SidneyMcAdams/CRT-420-Project/README.md

# CRT 420 Project
# This is the Github Repository CRT 420 Advanced Prototyping Class
