SidneyMcAdams/CRT-420-Project/Documentation/07-Function Production.pdf

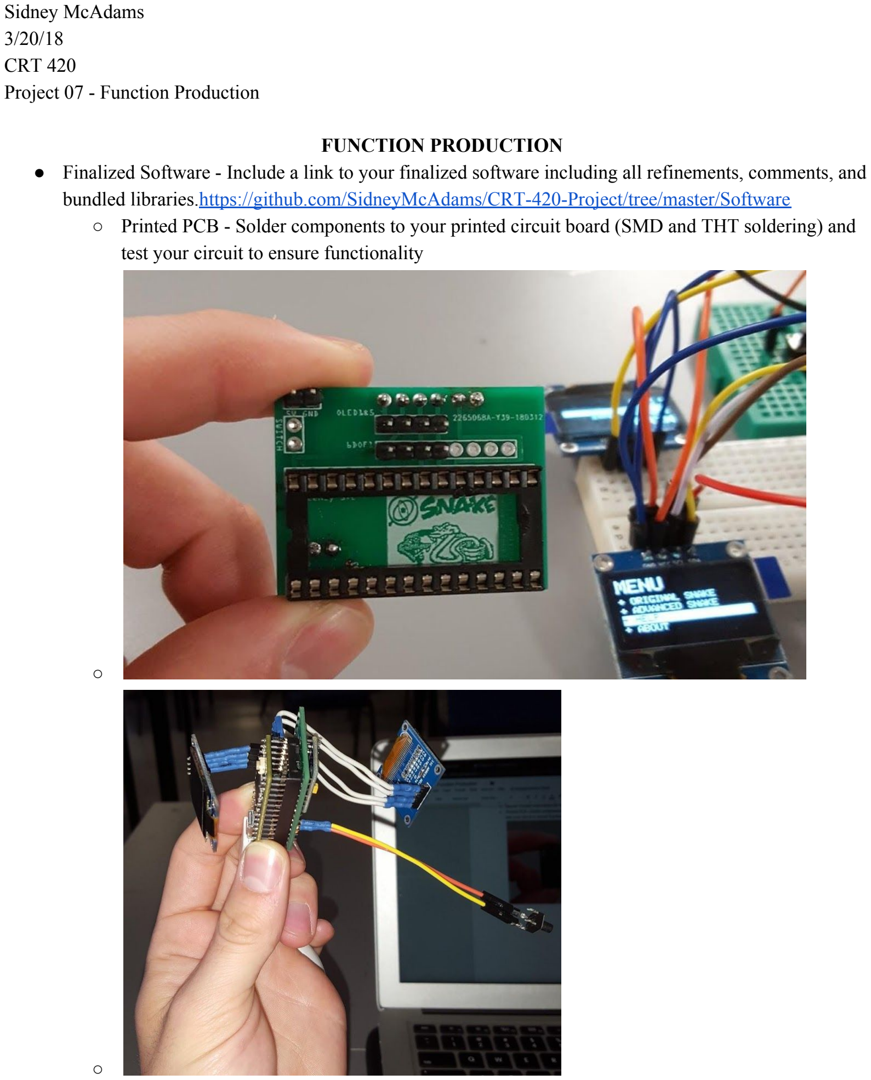
[picture p9: page 1]

Sidney McAdams
3/20/18
CRT 420
Project 07 - Function Production

FUNCTION PRODUCTION
- Finalized Software - Include a link to your finalized software including all refinements, comments, and bundled libraries.https://github.com/SidneyMcAdams/CRT-420-Project/tree/master/Software
- Printed PCB - Solder components to your printed circuit board (SMD and THT soldering) and test your circuit to ensure functionality

○

○

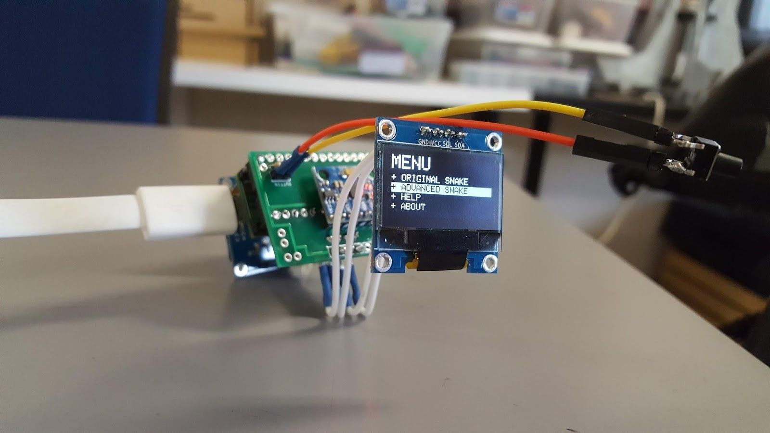
[picture p10: figure]

○
