SidneyMcAdams/CRT-420-Project/Documentation/09-Finalization.pdf

Sidney McAdams
4/11/18
CRT 420
Project 09 - Finalization

FINALIZATION

- Complete Project - Combine the functional and form components together into a completed prototype.

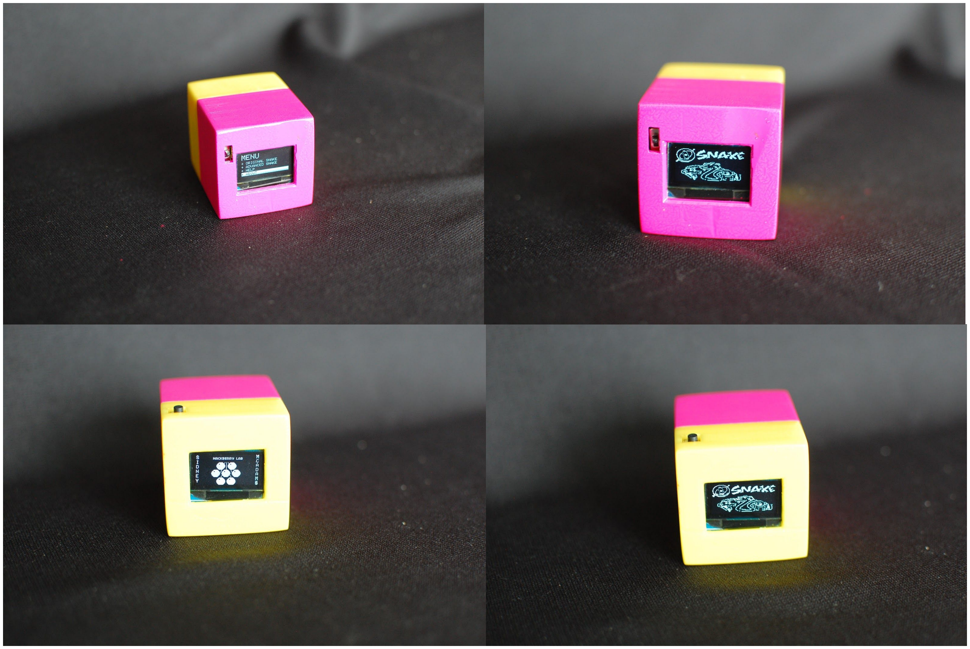
[picture p11: figure]

- User Testing - Generate a practical test of your device that includes a test of its hardware, software, and aesthetic features
■ Test with 3 individuals and record your results
- Rory: I like it.
- Meriah: Needs to be bigger.
- Dexter: Needs to be bigger.
- Power Requirements and Performance - Subject your device to power testing.
■ Test under the following conditions: idle performance, moderate usage, and frequent usage for 30 minutes each
- The device is able to be idle for up to 30+ minutes.
- It handles well to moderate and frequent usage.
- User was able to play ADVANCED SNAKE for 30+ minutes.
