SidneyMcAdams/CRT-420-Project/Documentation/08-Form Production.pdf

Sidney McAdams
3/28/18
CRT 420
Project 08 - Function Production

FORM PRODUCTION

- 3D Printed Model - Fabricate a 3D printed model based on your Fusion 360 model
■ Include any additional hardware such as standoffs, screws, etc. necessary to complete the design

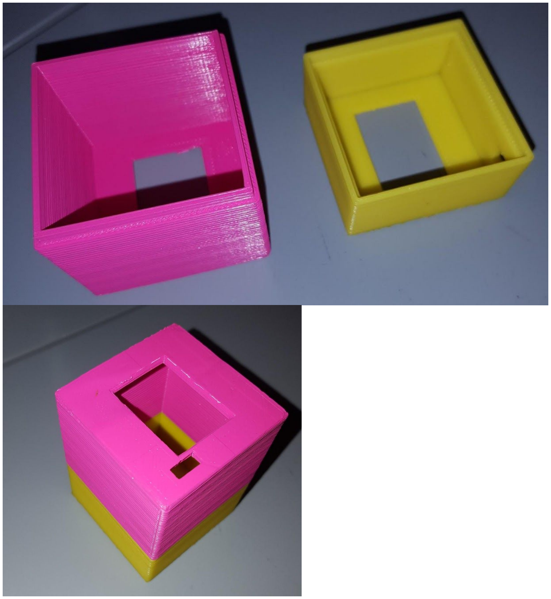
[picture p13: figure]

Before sanding and acetone vapor deposition

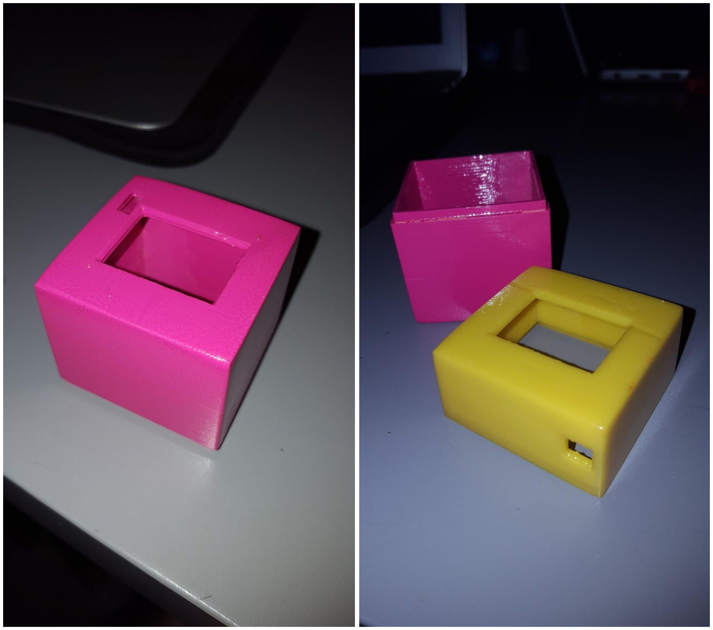
[picture p14: figure]

After sanding and acetone vapor deposition
