SidneyMcAdams/CRT-420-Project/Documentation/04-Function Development.pdf

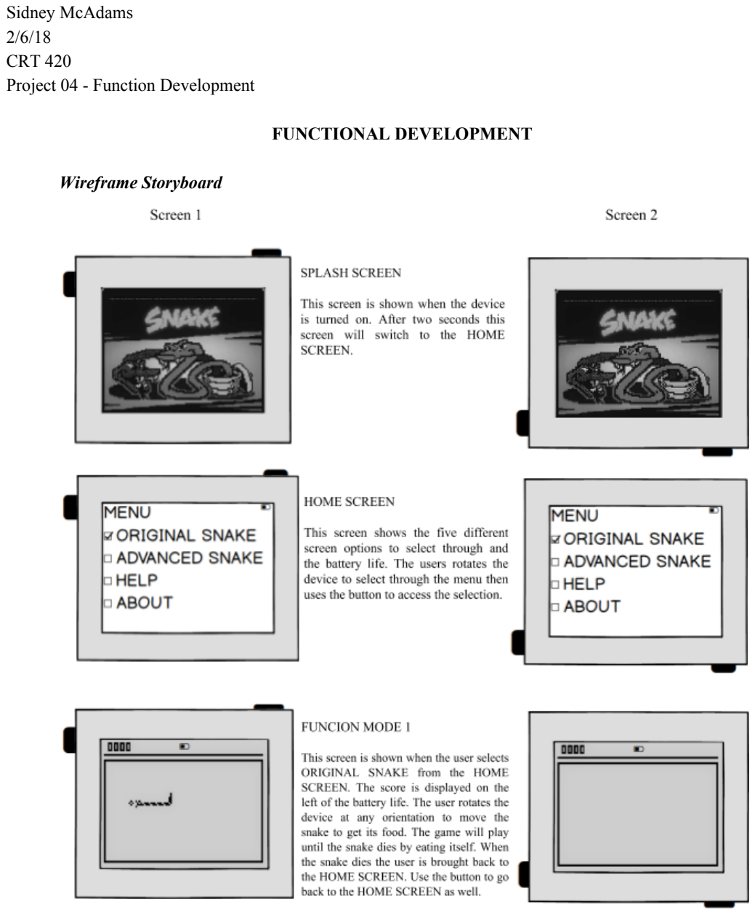
[picture p22: page 1]

Sidney McAdams
2/6/18
CRT 420
Project 04 - Function Development

FUNCTIONAL DEVELOPMENT

Wireframe Storyboard

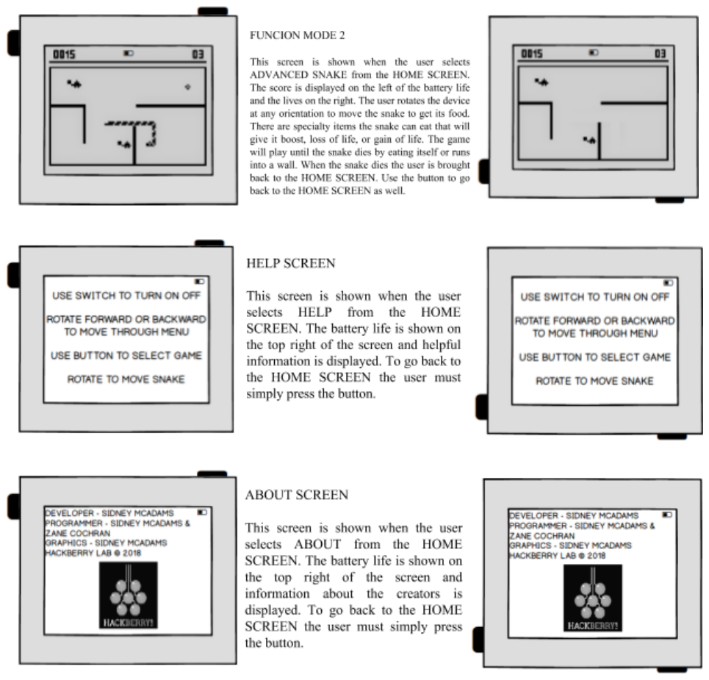
[picture p23: page 2]

Component Sketch

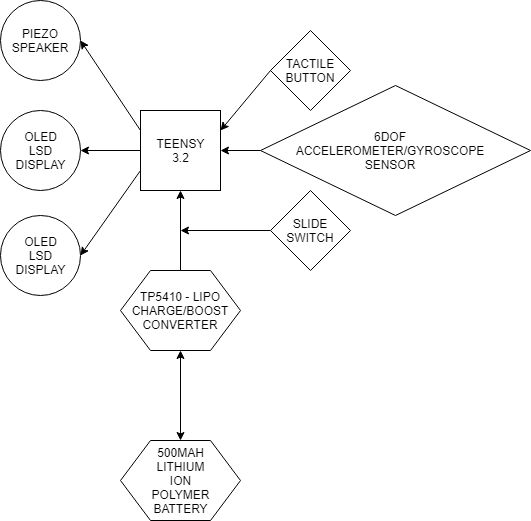
[picture p24: figure]

Bill of Materials

Item Name | Item Cost | Quantity Required | Reference URL | Purchase URL
Teensy 3.2 | $15.95 | 1 | Adafruit | https://www.adafrui t.com (https://www.adafruit.com/product/199)
.96” OLED Screen | $8.99 | 2 | Amazon | https://www.amazo n.com (https://www.amazon.com/Display-LANMU-Serial-128X64-Arduino/dp/B01G6RE2DQ)
Piezo Speaker | $.95 | 1 | Adafruit | https://www.adafrui t.com (https://www.adafruit.com/product/1740)
Slide Switch | $.95 | 1 | Adafruit | https://www.adafrui t.com (https://www.adafruit.com/product/805)
6 DOF Accelerometer/Gyr oscope Sensor | $5.09 | 1 | Amazon | https://www.amazo n.com (https://www.amazon.com/HiLetgo-MPU-6050-Accelerometer-Gyroscope-Converter/dp/B01DK83ZYQ)

Tactile Button | $2.50 | 1 | Adafruit | https://www.adafruit.com/product/367 (https://www.adafruit.com/product/367)
500mAh Lithium Ion Polymer Battery | $7.95 | 1 | Adafruit | https://www.adafrui t.com (https://www.adafruit.com/product/1578)
TP5410 - LiPo Charge/Boost Converter | $2.19 | 1 | Ebay | https://www.ebay.c om (https://www.ebay.com/itm/191990401129)
10k Ohm Resistor | $5.76 | 1 | Amazon | https://www.amazo n.com (https://www.amazon.com/Projects-10EP51210K0-10k-Resistors-Pack/dp/B0185FKB0K?s=industrial)
TOTAL: | $50.33
Breadboard Model - Create a breadboard model in Fritzing | simulating your circuit. Components should
be well spaced and wire jumpers should be discernible.

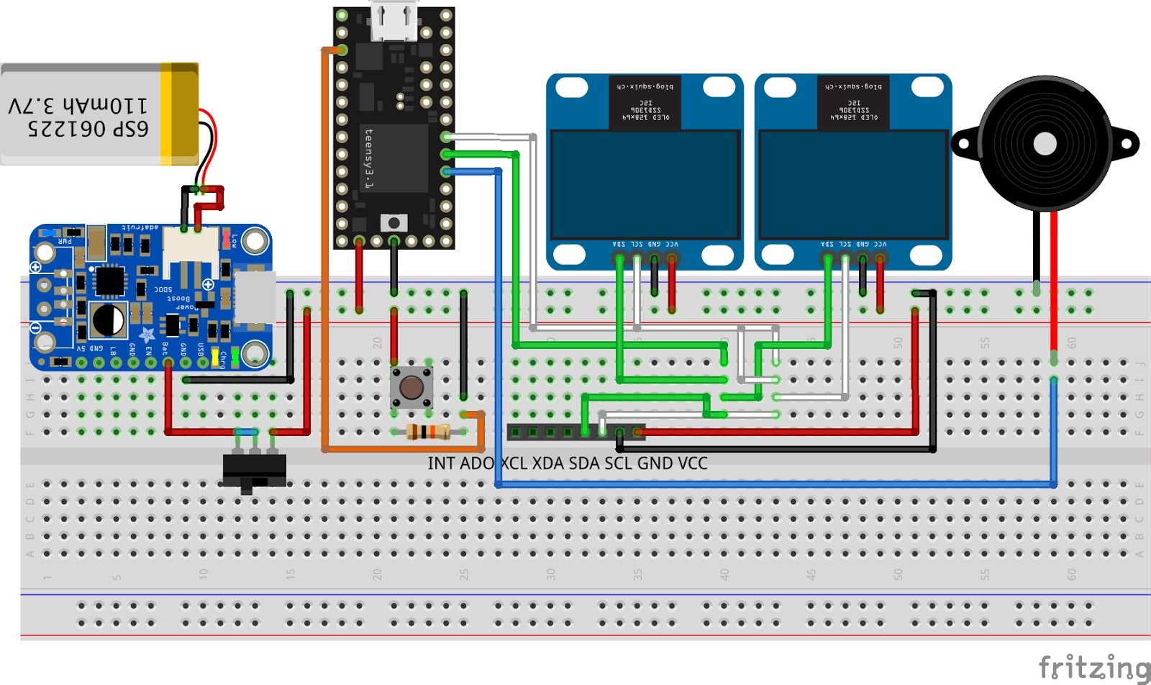
[picture p25: figure]

Electronic Schematic - Create an electronic schematic in Fritzing showing your circuit with appropriate connections made in a well organized manner.

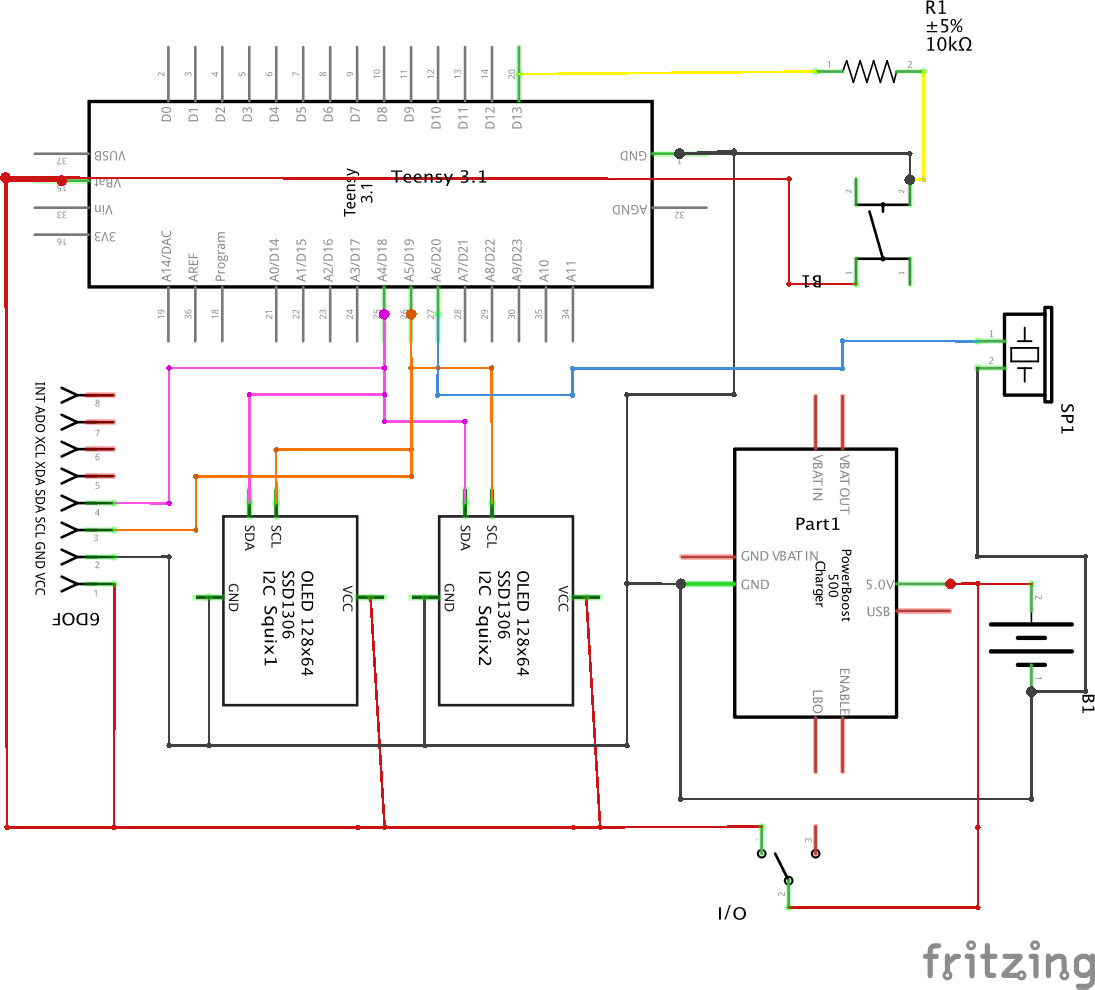
[picture p26: figure]
