SidneyMcAdams/CRT-420-Project/PinUps/PinUP #1.pdf

## PinUP #1 Covering: Function Proposal

Sidney McAdams
1/27/18
CRT 420 Advanced WhatchaMaCallIt

INPUTS

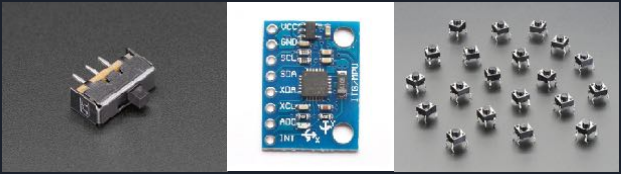
[picture p27: figure]

PROCESSING

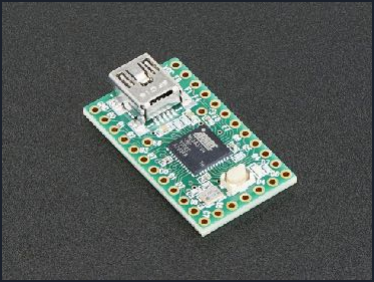
[picture p28: figure]

OUTPUTS

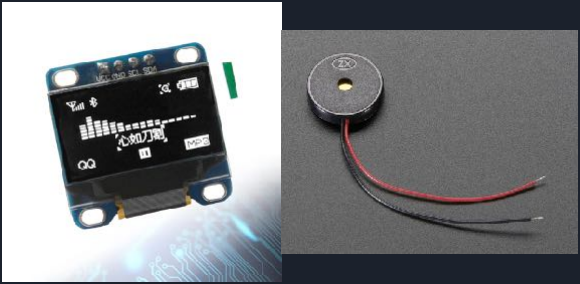
[picture p29: figure]

POWER

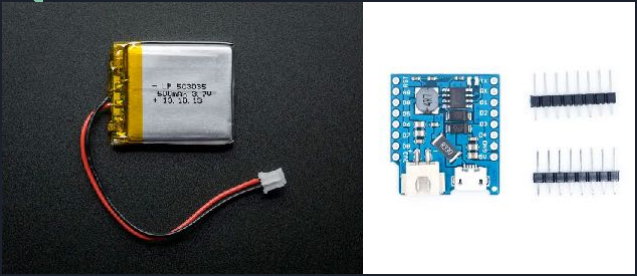
[picture p30: figure]

SOFTWARE

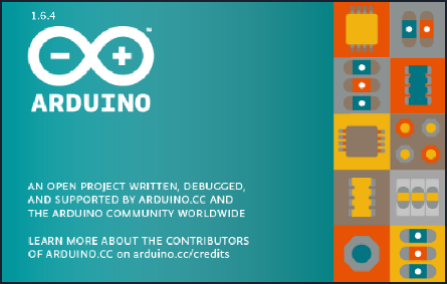
[picture p31: figure]

ADAFRUIT
GFX

ADAFRUIT
SSD1306

FREEimu

TONEac

ARDUINO IDE

MY WHATCHAMACALLIT

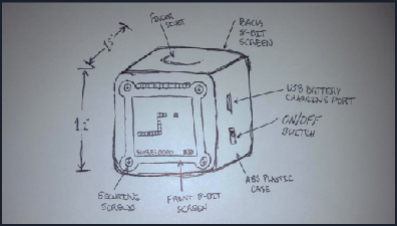
[picture p32: figure]
