SidneyMcAdams/CRT-420-Project/Documentation/00-Poster.pdf

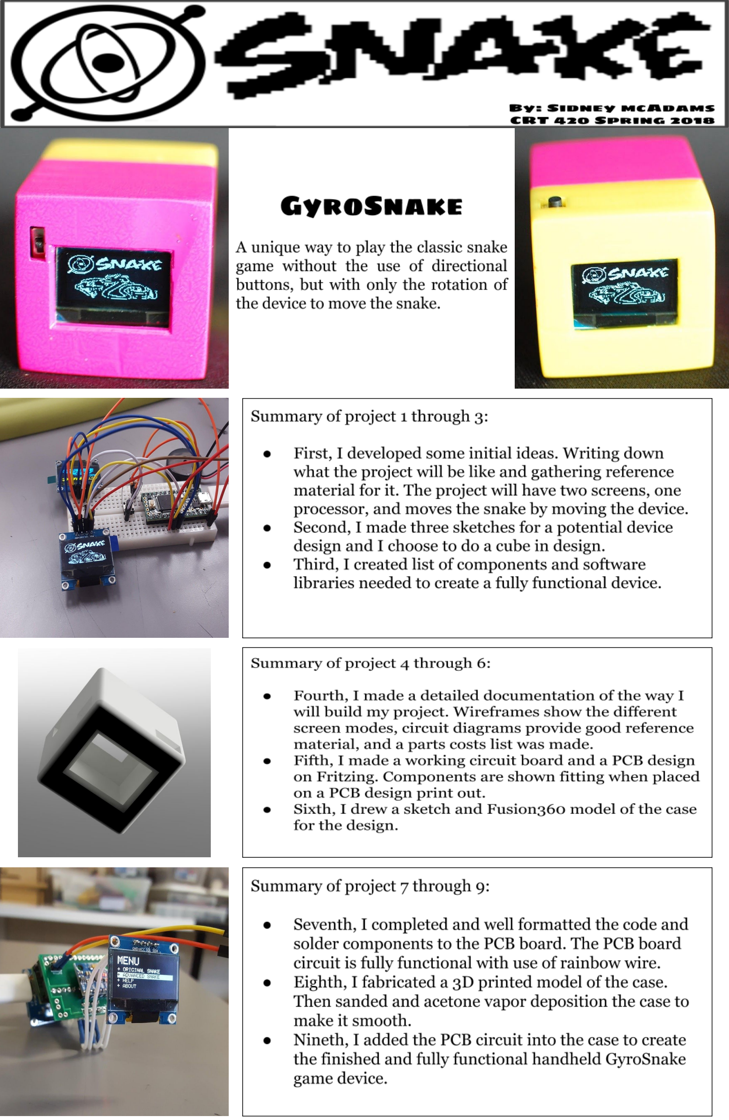
[picture p33: page 1]
