SidneyMcAdams/CRT-420-Project/Documentation/06-Form Proof.pdf

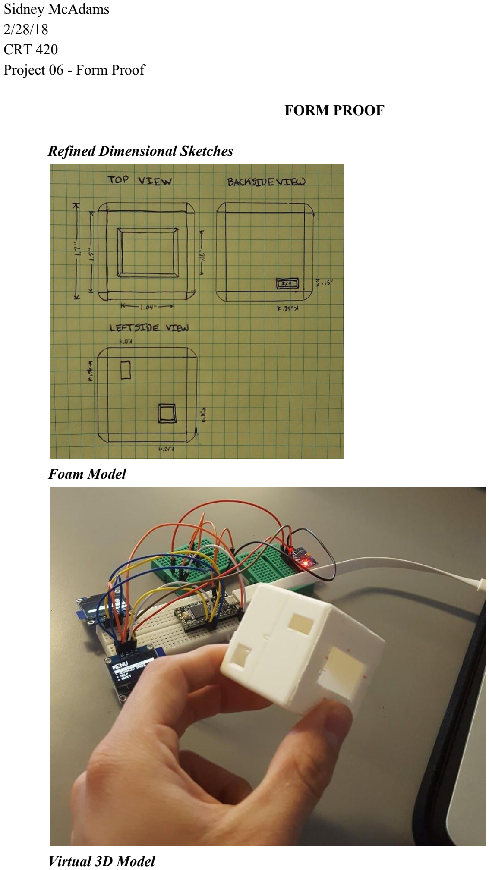
[picture p34: page 1]

Sidney McAdams
2/28/18
CRT 420
Project 06 - Form Proof

FORM PROOF

Refined Dimensional Sketches

Foam Model

Virtual 3D Model

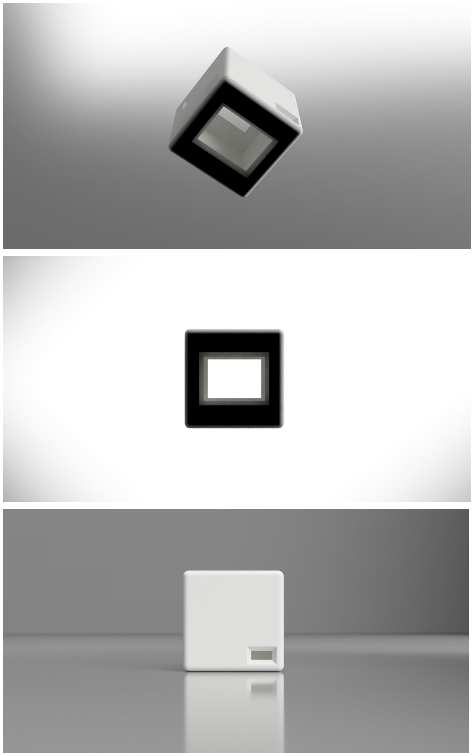
[picture p35: page 2]
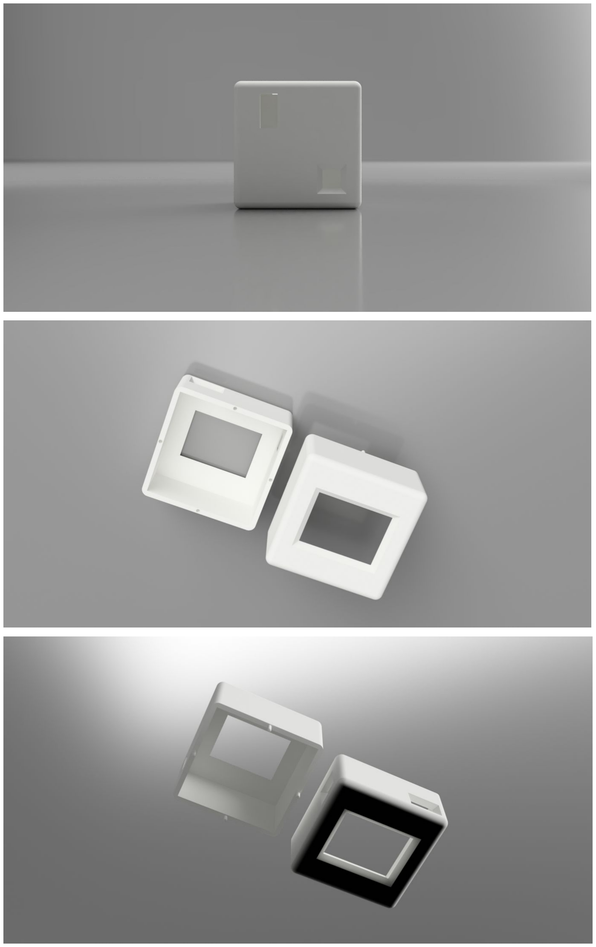
[picture p36: page 3]
