SidneyMcAdams/CRT-420-Project/PCB Files/FunctionProofPCB_pcb.png

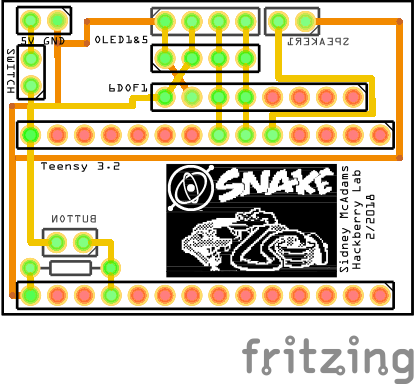
PCB Files/FunctionProofPCB_pcb.png
