SidneyMcAdams/CRT-420-Project/(list of files, drawings)

Other design files:
PCB Files/FunctionProofPCB.fzz
