SidneyMcAdams/CRT-420-Project/Software/SnakeGame/SnakeGame.ino

/*
  Sidney McAdams
  CRT 420 Final Project Code
  Mentor: Zane Cochran
  GyroSNAKE - A new and creative way to play the snake game. 
  Say goodbye to directional buttons and hello to 6-DOF IMU.
  With this code rotational movements of the device changes 
  the directional movement of the snake.  
*/

// OLED .96' DISPLAY SETUP
#include <SPI.h>
#include <Wire.h>
#include <Adafruit_GFX.h>
#include <Adafruit_SSD1306.h>
#define OLED_RESET 4

Adafruit_SSD1306 display1(OLED_RESET);
Adafruit_SSD1306 display2(OLED_RESET);

// MPU-6050 SETUP CODE
const int MPU_addr = 0x68; // I2C address of the MPU-6050
int16_t AcX, AcY, AcZ, Tmp, GyX, GyY, GyZ;
int snakeX[10] = { 64, -1, -1, -1, -1, -1, -1, -1, -1, -1};
int snakeY[10] = { 32, -1, -1, -1, -1, -1, -1, -1, -1, -1};
int snakeLength = 1;
int snakeDir = 0;

// FOR CHANGING SCREEN CASES
int mode = 0;
int lastMode = -1;
int curSelection = 0;
int button1 = 2;
int buttonDelay = 100;
boolean debug = true;

boolean activeScreen = 0;

// SCORE
long score = 0;
long lives = 3;

// FOOD
int minX = 10;
int minY = 10;
int maxX = 128;
int maxY = 64;
int foodX = random(10, 122);
int foodY = random(10, 59);
int foodScreen = random(0, 2);

// NOT FOOD FOR ADVANCED SNAKE
long nftimer = 0;

// CHECK BUTTON STATE
int checkButton() {
  if (digitalRead(button1) == HIGH) {
    delay(buttonDelay);
    if (debug) {
      Serial.println("LOW");
    } return 1;
  }
  return 0;
}

// WITHOUT THIS THE SCREEN WOULD BE BLANK
void setup() {
  randomSeed(analogRead(0));
  initDisplay();
  initAccel();
  initBUTTON();
}

// TURNS ON SCREENS AND CLEARS THE DISPLAYS
void initDisplay()   {
  Serial.begin(9600);
  display1.begin(SSD1306_SWITCHCAPVCC, 0x3C);
  display2.begin(SSD1306_SWITCHCAPVCC, 0x3D);
  display1.clearDisplay(); // clears screen
  display2.clearDisplay();
}

// TURNS ON 6-DOF IMU 
void initAccel() {
  Wire.begin();
  Wire.beginTransmission(MPU_addr);
  Wire.write(0x6B);  // PWR_MGMT_1 register
  Wire.write(0);     // set to zero (wakes up the MPU-6050)
  Wire.endTransmission(true);
}

// ALLOWS BUTTON TO FUNCTION AND SETS THE PROPER PIN TO IT
void initBUTTON() {
  pinMode(button1, INPUT);
}


void loop() {
  checkAccel();
  loadMode();

  if (activeScreen == 0) {
    display1.display();
    if(mode != 3){display1.clearDisplay();}
  }
  else if (activeScreen == 1) {
    display2.display();
    if(mode != 3){display2.clearDisplay();}
  }
}

// CREATES DIFFERENT CASE MODES FOR THE USER TO SELECT THROUGH ON THE MENU SCREEN
void loadMode() {
  switch (mode) {
    case 0: splash(); break;
    case 1: mainMenu(); break;
    case 2: originalSnake(); break;
    case 3: advanceSnake(); break;
    case 4: help(); break;
    case 5: about(); break;
  }
  // Clear Screen if Mode Changes
  if (lastMode != mode) {
    lastMode = mode;
    if(mode == 3){display1.clearDisplay();}
    if(mode == 3){display2.clearDisplay();}
  }
}

// IDENTIFIES WHAT ORIENTATION THE 6-DOF IMU IS AT AND TURNS ON THE SCREEN DEPENDENT ON IF ITS ORIENTATION IS UP OR DOWN
void checkAccel() {
  Wire.beginTransmission(MPU_addr);
  Wire.write(0x3B);  // starting with register 0x3B (ACCEL_XOUT_H)
  Wire.endTransmission(false);
  Wire.requestFrom(MPU_addr, 14, true); // request a total of 14 registers
  AcX = Wire.read() << 8 | Wire.read(); // 0x3B (ACCEL_XOUT_H) & 0x3C (ACCEL_XOUT_L)
  AcY = Wire.read() << 8 | Wire.read(); // 0x3D (ACCEL_YOUT_H) & 0x3E (ACCEL_YOUT_L)
  AcZ = Wire.read() << 8 | Wire.read(); // 0x3F (ACCEL_ZOUT_H) & 0x40 (ACCEL_ZOUT_L)

  if (AcZ > 0) {
    activeScreen = 1;
  }
  else {
    activeScreen = 0;
  }

  Serial.print(AcX); Serial.print(", "); Serial.print(AcY); Serial.print(", "); Serial.print(AcZ); Serial.print(" || Screen:"); Serial.println(activeScreen);
}
