SidneyMcAdams/CRT-420-Project/Software/SnakeGame/Tab01-SpashScreen.ino

const unsigned char SnakeGame [] PROGMEM = {
  // 'SnakeGame, 128x64px
  0x00, 0x00, 0x00, 0x00, 0x00, 0x00, 0x00, 0x00, 0x00, 0x00, 0x00, 0x00, 0x00, 0x00, 0x00, 0x00, 
  0x00, 0x07, 0xff, 0x00, 0xe0, 0x00, 0x00, 0x00, 0x00, 0x00, 0x00, 0x00, 0x00, 0x00, 0x00, 0x00, 
  0x00, 0x38, 0x00, 0xe0, 0xe0, 0x00, 0x30, 0x00, 0x00, 0x00, 0x00, 0x00, 0x00, 0x00, 0x00, 0x80, 
  0x00, 0xc0, 0x00, 0x19, 0x80, 0x00, 0x78, 0x00, 0x00, 0x00, 0x00, 0x80, 0x18, 0x00, 0x03, 0xc0, 
  0x03, 0x80, 0x00, 0x0f, 0x00, 0x07, 0xf8, 0x00, 0x00, 0x78, 0x07, 0xc0, 0x78, 0x07, 0x1f, 0xe0, 
  0x06, 0x03, 0x8f, 0xe3, 0x00, 0x0f, 0xfc, 0x1f, 0x80, 0xf8, 0x1f, 0xc3, 0xf8, 0x0f, 0xcf, 0xf8, 
  0x0c, 0x04, 0xe0, 0x19, 0x80, 0x3f, 0xfc, 0x3f, 0x81, 0xf8, 0x3f, 0xc1, 0xf8, 0x1f, 0x8e, 0x00, 
  0x18, 0x05, 0x10, 0x0c, 0x80, 0x7f, 0xc0, 0x3f, 0xc1, 0xf0, 0x7f, 0xc0, 0x18, 0x7f, 0x30, 0x00, 
  0x10, 0x00, 0x08, 0x04, 0x40, 0xff, 0x00, 0x3f, 0xe1, 0xf0, 0xf9, 0xe0, 0x18, 0xfc, 0xf0, 0x00, 
  0x30, 0x08, 0x00, 0x04, 0x60, 0xf8, 0x00, 0x7f, 0xe1, 0xf0, 0xf9, 0xe3, 0xcf, 0xf8, 0xf0, 0x00, 
  0x20, 0x20, 0x04, 0x04, 0x21, 0xe0, 0x00, 0x3c, 0xf1, 0xf1, 0xf0, 0xff, 0xcf, 0xe0, 0xf3, 0x80, 
  0x20, 0x64, 0x00, 0x04, 0x23, 0xe0, 0x3f, 0x9c, 0x79, 0xf3, 0xe0, 0xff, 0x0f, 0xc0, 0x7e, 0x00, 
  0x60, 0x44, 0xfa, 0x04, 0x23, 0xef, 0xff, 0xdc, 0x7f, 0xf3, 0xe3, 0xfc, 0x1f, 0xe0, 0x7c, 0x00, 
  0x60, 0x80, 0xf8, 0x08, 0x23, 0xff, 0xbf, 0xdc, 0x1f, 0xf3, 0xff, 0xfc, 0x3f, 0xf8, 0x3c, 0xf0, 
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
  } else {
  display2.setCursor(0, 0);
  display2.setTextColor(WHITE, BLACK);
  display2.setTextWrap(true);
  display2.drawBitmap(0, 0, SnakeGame, 128, 64, WHITE); //SHOWS THE IMAGE
  display2.display();
  }
  delay(2000);
  //display1.clearDisplay();
  //display2.clearDisplay();
  mode = 1;
}
