SidneyMcAdams/CRT-420-Project/Software/SnakeGame/Tab06-About.ino

const unsigned char Hackberry [] PROGMEM = {
  // 'SnakeGame, 128x64px
  0x00, 0x00, 0x00, 0x00, 0x00, 0x00, 0x00, 0x00, 0x00, 0x00, 0x00, 0x00, 0x00, 0x00, 0x00, 0x00,
  0x00, 0x00, 0x00, 0x00, 0x00, 0x00, 0x00, 0x00, 0x00, 0x00, 0x00, 0x00, 0x00, 0x00, 0x00, 0x00,
  0x00, 0x00, 0x00, 0x00, 0x00, 0x00, 0x00, 0x00, 0x00, 0x00, 0x00, 0x00, 0x00, 0x00, 0x00, 0x00,
  0x00, 0x00, 0x00, 0x00, 0x00, 0x00, 0x00, 0x00, 0x00, 0x00, 0x00, 0x00, 0x00, 0x00, 0x00, 0x00,
  0x00, 0x00, 0x00, 0x00, 0x00, 0x00, 0x00, 0x00, 0x00, 0x00, 0x00, 0x00, 0x00, 0x00, 0x00, 0x00,
  0x00, 0x00, 0x00, 0x00, 0x24, 0xc6, 0x97, 0x3b, 0x9c, 0x90, 0x43, 0x38, 0x00, 0x00, 0x00, 0x00,
  0x00, 0x00, 0x00, 0x00, 0x25, 0x28, 0xa4, 0xa2, 0x52, 0x90, 0x44, 0xa4, 0x00, 0x00, 0x00, 0x00,
  0x00, 0x00, 0x00, 0x00, 0x3d, 0x28, 0xc7, 0x3a, 0x52, 0x70, 0x44, 0xb8, 0x00, 0x00, 0x00, 0x00,
  0x00, 0x00, 0x00, 0x00, 0x25, 0xe8, 0xa4, 0xa3, 0x9c, 0x10, 0x47, 0xa4, 0x00, 0x00, 0x00, 0x00,
  0x00, 0x00, 0x00, 0x00, 0x25, 0x26, 0x97, 0x3a, 0x52, 0x60, 0x74, 0xb8, 0x00, 0x00, 0x00, 0x00,
  0x00, 0x00, 0x00, 0x00, 0x00, 0x00, 0x00, 0x00, 0x00, 0x00, 0x00, 0x00, 0x00, 0x00, 0x00, 0x00,
  0x00, 0x00, 0x00, 0x00, 0x00, 0x00, 0x00, 0x00, 0x00, 0x00, 0x00, 0x00, 0x00, 0x00, 0x00, 0x00,
  0x00, 0x00, 0x00, 0x00, 0x00, 0x00, 0x00, 0x00, 0x00, 0x00, 0x00, 0x00, 0x00, 0x00, 0x00, 0x00,
  0x00, 0x00, 0x00, 0x00, 0x00, 0x00, 0x00, 0x00, 0x00, 0x00, 0x00, 0x00, 0x00, 0x00, 0x00, 0x00,
  0x00, 0x00, 0x00, 0x00, 0x00, 0x00, 0x00, 0x00, 0x00, 0x00, 0x00, 0x00, 0x00, 0x00, 0x00, 0x00,
  0x00, 0x00, 0x00, 0x00, 0x00, 0x00, 0x00, 0x00, 0x00, 0x00, 0x00, 0x00, 0x00, 0x00, 0x00, 0x00,
  0x00, 0x00, 0x00, 0x00, 0x00, 0x03, 0xfc, 0x24, 0x87, 0xf8, 0x00, 0x00, 0x00, 0x00, 0x00, 0x00,
  0x00, 0x00, 0x00, 0x00, 0x00, 0x07, 0xfe, 0x44, 0x4f, 0xfc, 0x00, 0x00, 0x00, 0x00, 0x00, 0x00,
  0x00, 0x00, 0x00, 0x00, 0x00, 0x0f, 0xff, 0x84, 0x3f, 0xfe, 0x00, 0x00, 0x00, 0x00, 0x00, 0x00,
  0x00, 0x00, 0x00, 0x00, 0x00, 0x1c, 0xff, 0x84, 0x39, 0xff, 0x00, 0x00, 0x00, 0x00, 0x00, 0x00,
  0x00, 0x00, 0x00, 0x00, 0x00, 0x3c, 0xff, 0xc4, 0x79, 0xff, 0x80, 0x00, 0x00, 0x00, 0x00, 0x00,
  0x00, 0x00, 0x00, 0x00, 0x00, 0x3f, 0xff, 0xc4, 0x7f, 0xff, 0x80, 0x00, 0x00, 0x00, 0x00, 0x00,
  0x00, 0x00, 0x00, 0x00, 0x00, 0x7f, 0xff, 0xe4, 0xff, 0xff, 0xc0, 0x00, 0x00, 0x00, 0x00, 0x00,
  0x00, 0x00, 0x00, 0x00, 0x00, 0x7f, 0xff, 0xe4, 0xff, 0xff, 0xc0, 0x00, 0x00, 0x00, 0x00, 0x00,
  0x00, 0x00, 0x00, 0x00, 0x00, 0x7f, 0xff, 0xe4, 0xff, 0xff, 0xc0, 0x00, 0x00, 0x00, 0x00, 0x00,
  0x00, 0x00, 0x00, 0x00, 0x00, 0x7f, 0xff, 0xe4, 0xff, 0xff, 0xc0, 0x00, 0x00, 0x00, 0x00, 0x00,
  0x00, 0x00, 0x00, 0x00, 0x00, 0x3f, 0xff, 0xc4, 0x7f, 0xff, 0x80, 0x00, 0x00, 0x00, 0x00, 0x00,
  0x00, 0x00, 0x00, 0x00, 0x00, 0x3f, 0xff, 0xc4, 0x7f, 0xff, 0x80, 0x00, 0x00, 0x00, 0x00, 0x00,
  0x00, 0x00, 0x00, 0x00, 0x00, 0x1f, 0xff, 0x84, 0x3f, 0xff, 0x00, 0x00, 0x00, 0x00, 0x00, 0x00,
  0x00, 0x00, 0x00, 0x00, 0x00, 0x0f, 0xff, 0x04, 0x1f, 0xfe, 0x00, 0x00, 0x00, 0x00, 0x00, 0x00,
  0x00, 0x00, 0x00, 0x00, 0x00, 0x07, 0xfe, 0x04, 0x0f, 0xfc, 0x00, 0x00, 0x00, 0x00, 0x00, 0x00,
  0x00, 0x00, 0x00, 0x00, 0x00, 0x03, 0xfc, 0x04, 0x07, 0xf8, 0x00, 0x00, 0x00, 0x00, 0x00, 0x00,
  0x00, 0x00, 0x00, 0x00, 0x0f, 0xf0, 0x10, 0x7f, 0x81, 0x03, 0xfc, 0x00, 0x00, 0x00, 0x00, 0x00,
  0x00, 0x00, 0x00, 0x00, 0x1f, 0xf8, 0x10, 0xff, 0xc1, 0x07, 0xfe, 0x00, 0x00, 0x00, 0x00, 0x00,
  0x00, 0x00, 0x00, 0x00, 0x3f, 0xfc, 0x11, 0xff, 0xe1, 0x0f, 0xff, 0x00, 0x00, 0x00, 0x00, 0x00,
  0x00, 0x00, 0x00, 0x00, 0x73, 0xfe, 0x13, 0x9f, 0xf1, 0x1c, 0xff, 0x80, 0x00, 0x00, 0x00, 0x00,
  0x00, 0x00, 0x00, 0x00, 0xf3, 0xff, 0x27, 0x9f, 0xf8, 0xbc, 0xff, 0xc0, 0x00, 0x00, 0x00, 0x00,
  0x00, 0x00, 0x00, 0x00, 0xff, 0xff, 0x47, 0xff, 0xf8, 0x7f, 0xff, 0xc0, 0x00, 0x00, 0x00, 0x00,
  0x00, 0x00, 0x00, 0x01, 0xff, 0xff, 0x8f, 0xff, 0xfc, 0x7f, 0xff, 0xe0, 0x00, 0x00, 0x00, 0x00,
  0x00, 0x00, 0x00, 0x01, 0xff, 0xff, 0x8f, 0xff, 0xfc, 0x7f, 0xff, 0xe0, 0x00, 0x00, 0x00, 0x00,
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
};

// DISPLAYS THE BITMAP IMAGE ABOVE ON THE SCREEN PLUS SOME TEXT 
void about() {
  if (activeScreen == 0) {
  display1.setCursor(0, 2);
  display1.setTextColor(WHITE, BLACK);
  display1.setTextWrap(true);
  display1.drawBitmap(0, 0, Hackberry, 128, 64, WHITE); //SHOWS THE IMAGE
  display2.setTextSize(1);

  display1.println("S");
  display1.setCursor(0, 12);
  display1.println("I");
  display1.setCursor(0, 22);
  display1.println("D");
  display1.setCursor(0, 32);
  display1.println("N");
  display1.setCursor(0, 42);
  display1.println("E");
  display1.setCursor(0, 52);
  display1.println("Y");

  display1.setCursor(122, 0);
  display1.println("M");
  display1.setCursor(122, 9);
  display1.println("C");
  display1.setCursor(122, 18);
  display1.println("A");
  display1.setCursor(122, 28);
  display1.println("D");
  display1.setCursor(122, 37);
  display1.println("A");
  display1.setCursor(122, 47);
  display1.println("M");
  display1.setCursor(122, 57);
  display1.println("S");

  //display1.display();
  }else{
  display2.setCursor(0, 2);
  display2.setTextColor(WHITE, BLACK);
  display2.setTextWrap(true);
  display2.drawBitmap(0, 0, Hackberry, 128, 64, WHITE); //SHOWS THE IMAGE
  display2.setTextSize(1);

  display2.println("S");
  display2.setCursor(0, 12);
  display2.println("I");
  display2.setCursor(0, 22);
  display2.println("D");
  display2.setCursor(0, 32);
  display2.println("N");
  display2.setCursor(0, 42);
  display2.println("E");
  display2.setCursor(0, 52);
  display2.println("Y");

  display2.setCursor(122, 0);
  display2.println("M");
  display2.setCursor(122, 9);
  display2.println("C");
  display2.setCursor(122, 18);
  display2.println("A");
  display2.setCursor(122, 28);
  display2.println("D");
  display2.setCursor(122, 37);
  display2.println("A");
  display2.setCursor(122, 47);
  display2.println("M");
  display2.setCursor(122, 57);
  display2.println("S");

  //display2.display();
  }
int b = checkButton();
  if ( b == 1) {
    mode = 0;
  }
}
