SidneyMcAdams/CRT-420-Project/(commit log)

2018-01-15 Project 01 Concept Development
    Completed 10/14/17
    Gyroscopic Snake Game Gaming Device
2018-03-01 FunctionProofPCB
    New PCB
    [FunctionProofPCB.fzz]
2018-03-05 PCB
    Update
    [FunctionProofPCB.fzz]
2018-04-16 GyroSnake Code
    Software Update
